QuentinCaldeira/Arduino_Shield/Docs/Images/img.png

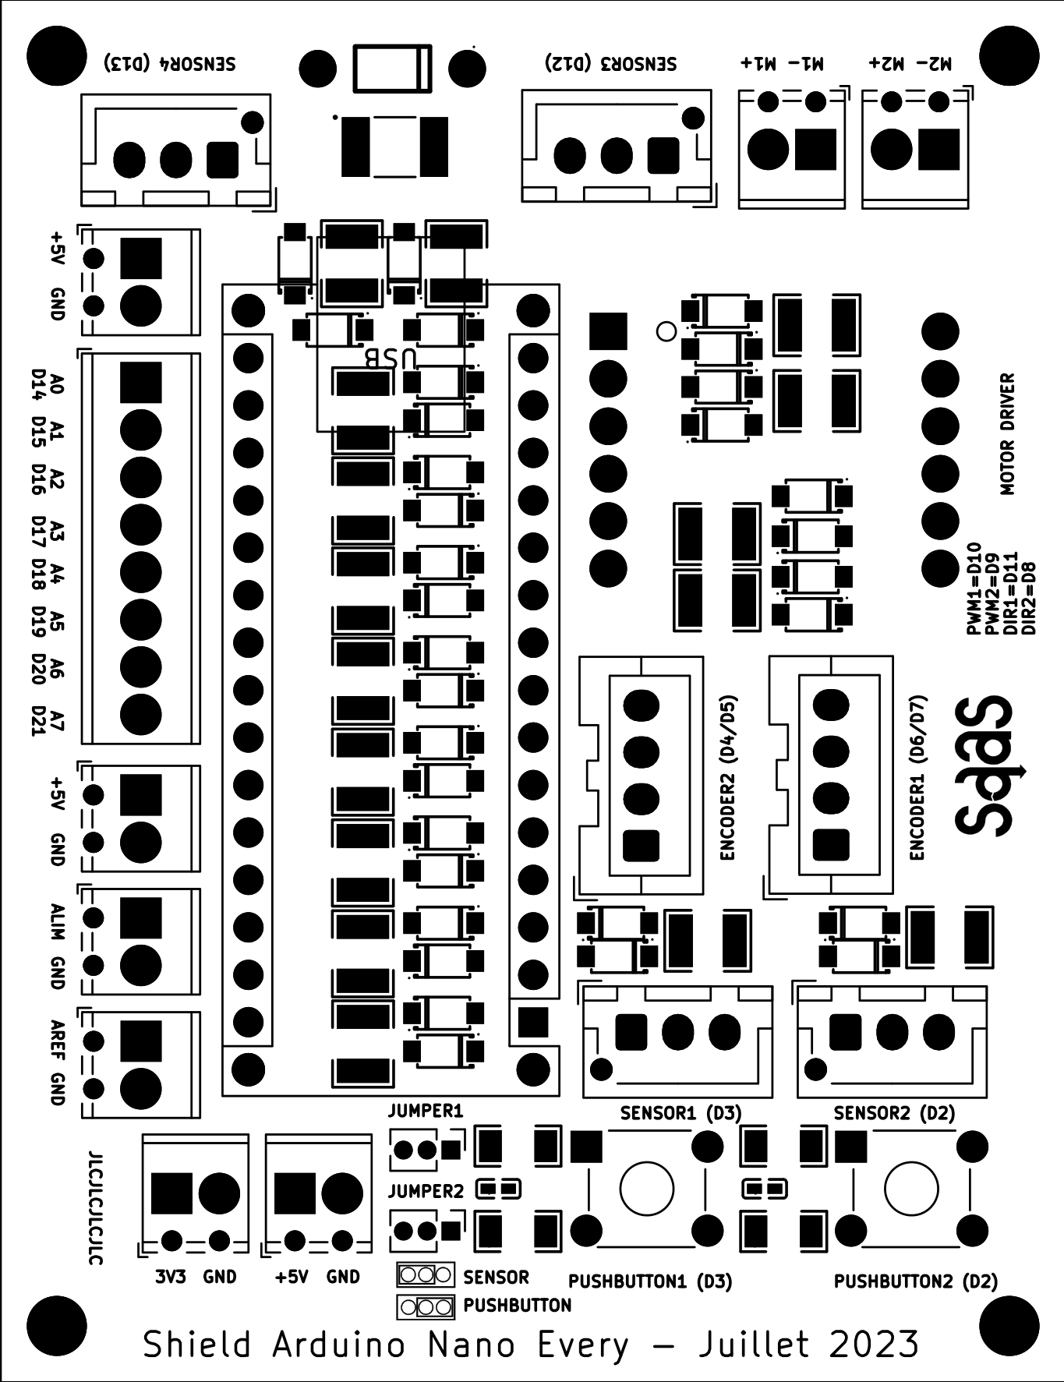
Docs/Images/img.png
