QuentinCaldeira/Arduino_Shield/SHIELD V2 PCB/BOM - Copie.xlsx

Comment | Designator | Footprint | JLCPCB Part #（optional）
330 | R1, R2, R3, R4, R5, R6, R7, R8, R9, R10, R11, R12, R13, R14, R15, R16 |  | C2933855
10k | R18, R20 |  | C3013377
Diode Schottky | D1, D2, D3, D4, D5, D6, D7, D8, D9, D10, D11, D12, D13, D14, D15, D16, D17, D18, D19, D20, D21, D22, D23, D24, D25, D26, D27, D28, D29, D30, D32, D33 |  | C8572
Diode | D31 |  | C2456
SMD | F1 |  | C108518
15nF | C1, C2 |  | C363529
110k | R17, R19 |  | C102274
 | J13, J3, J2, J1 |  | C161870
 | J10, J7 |  | C264994
 | J9, J11, J17, J6, J12, J19, J18, J4 |  | C2840316
