QuentinCaldeira/Arduino_Shield/Docs/Images/img.pdf

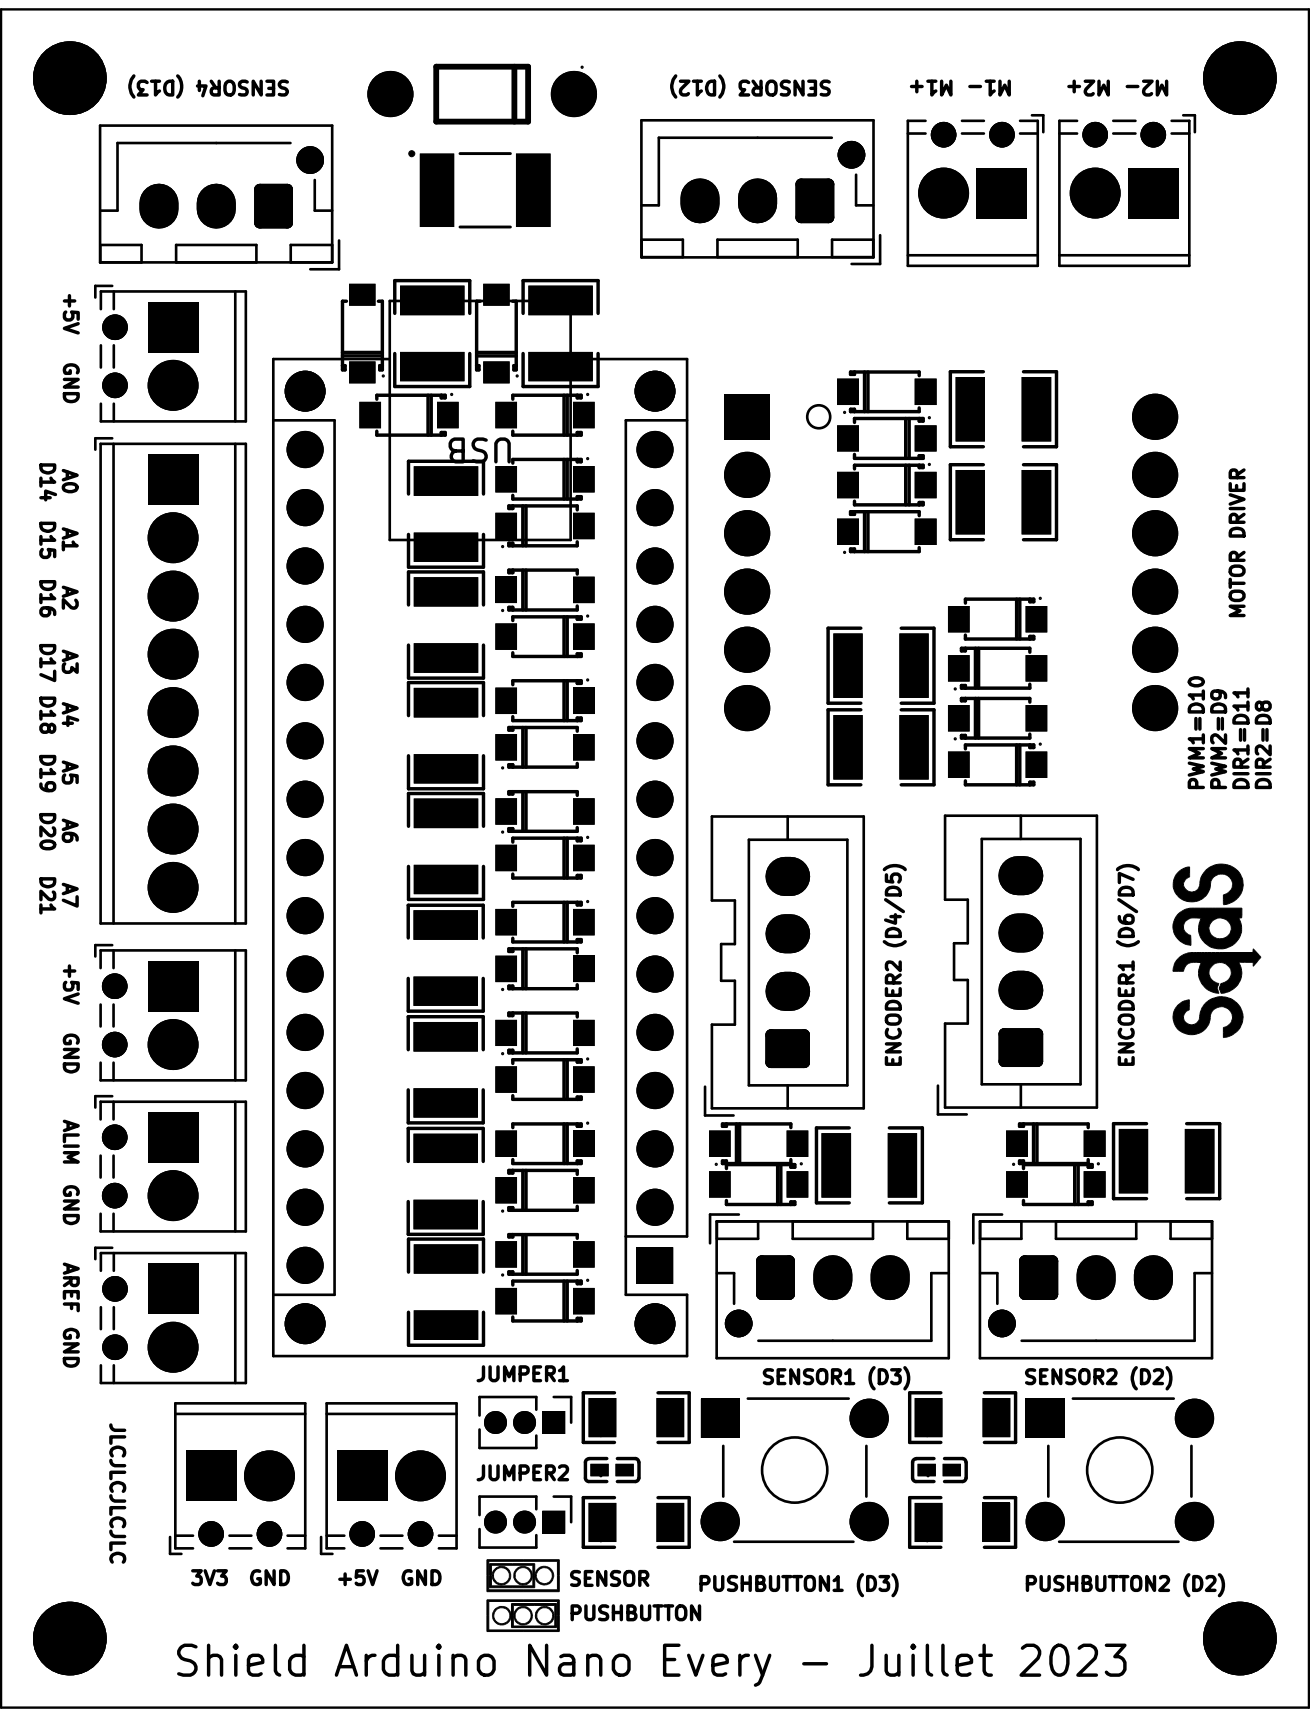
[picture p10: page 1]
