QuentinCaldeira/Arduino_Shield/SHIELD V1 PCB/bottom.pdf

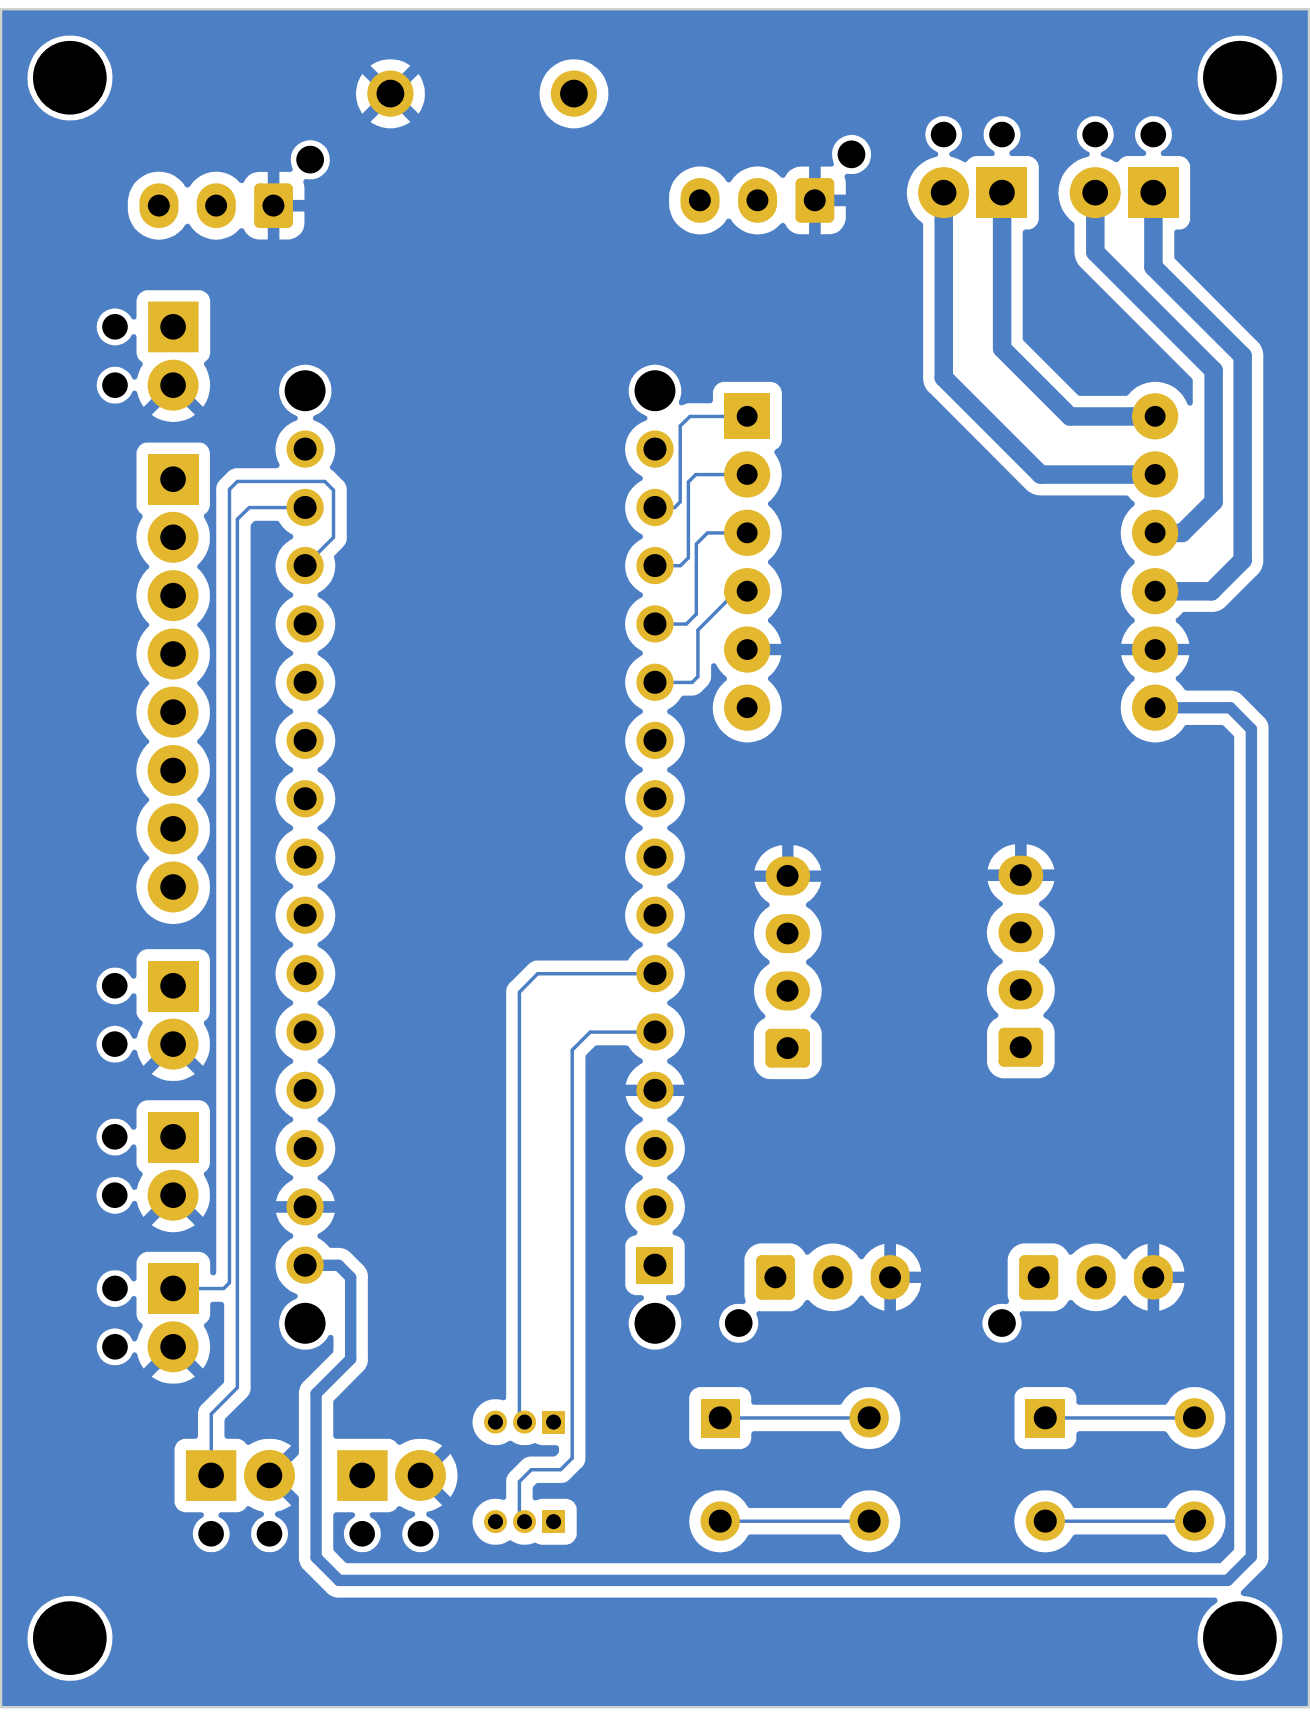
[picture p11: page 1]
