QuentinCaldeira/Arduino_Shield/SHIELD V1 PCB/cote.pdf

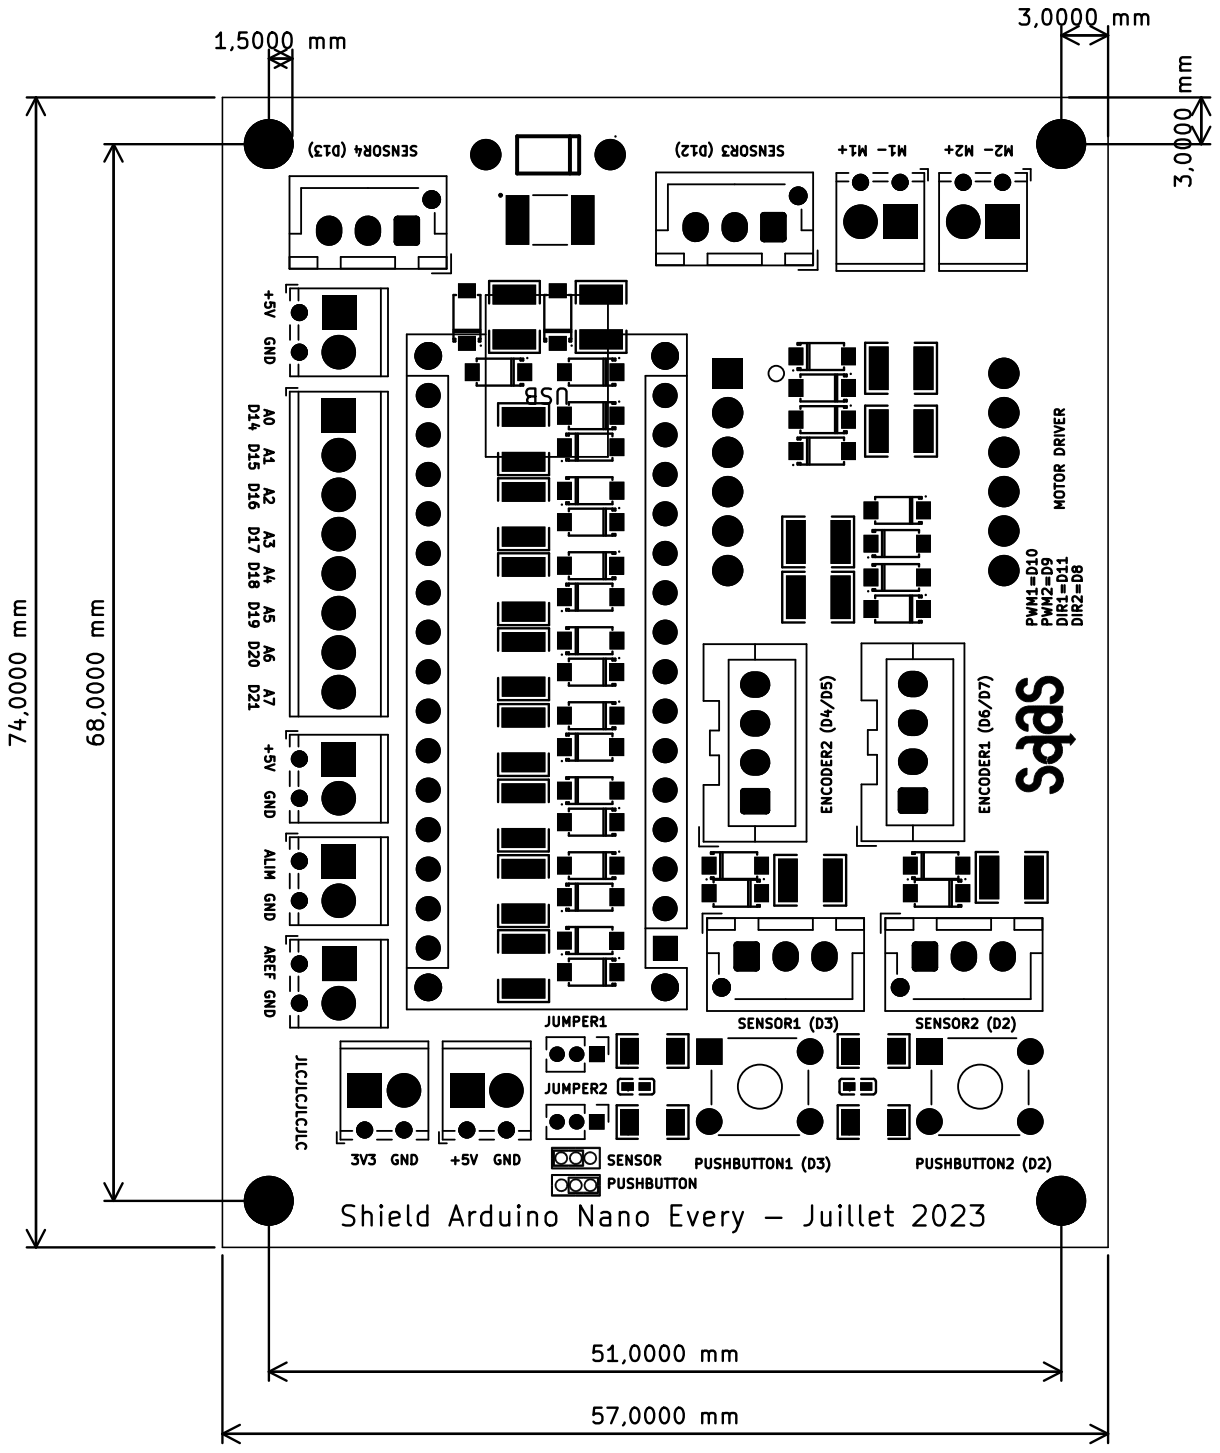
[picture p12: page 1]
