QuentinCaldeira/Arduino_Shield/SHIELD V1 PCB/sch.pdf

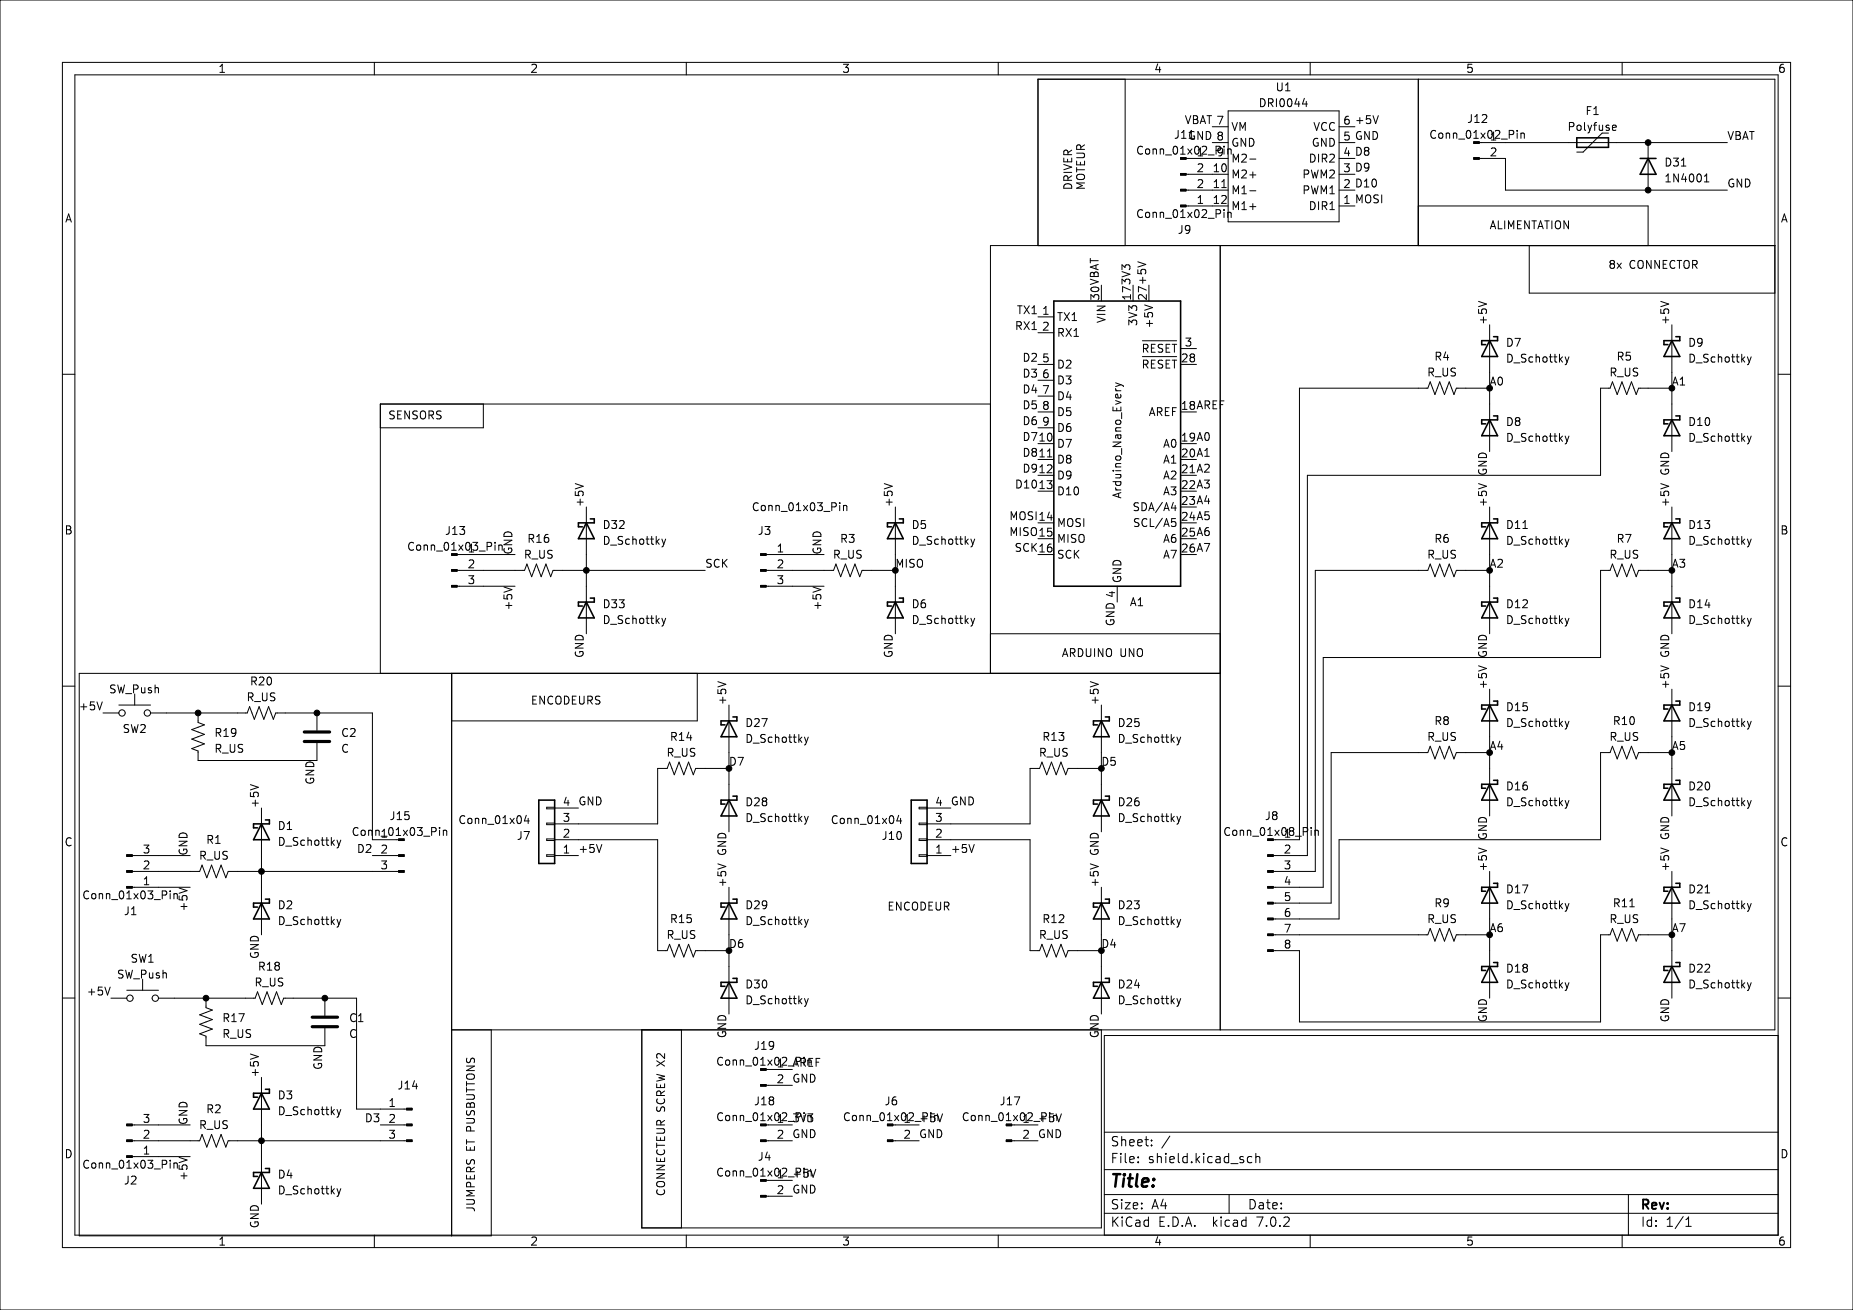
[picture p13: page 1]
