QuentinCaldeira/Arduino_Shield/SHIELD V1 PCB/top.pdf

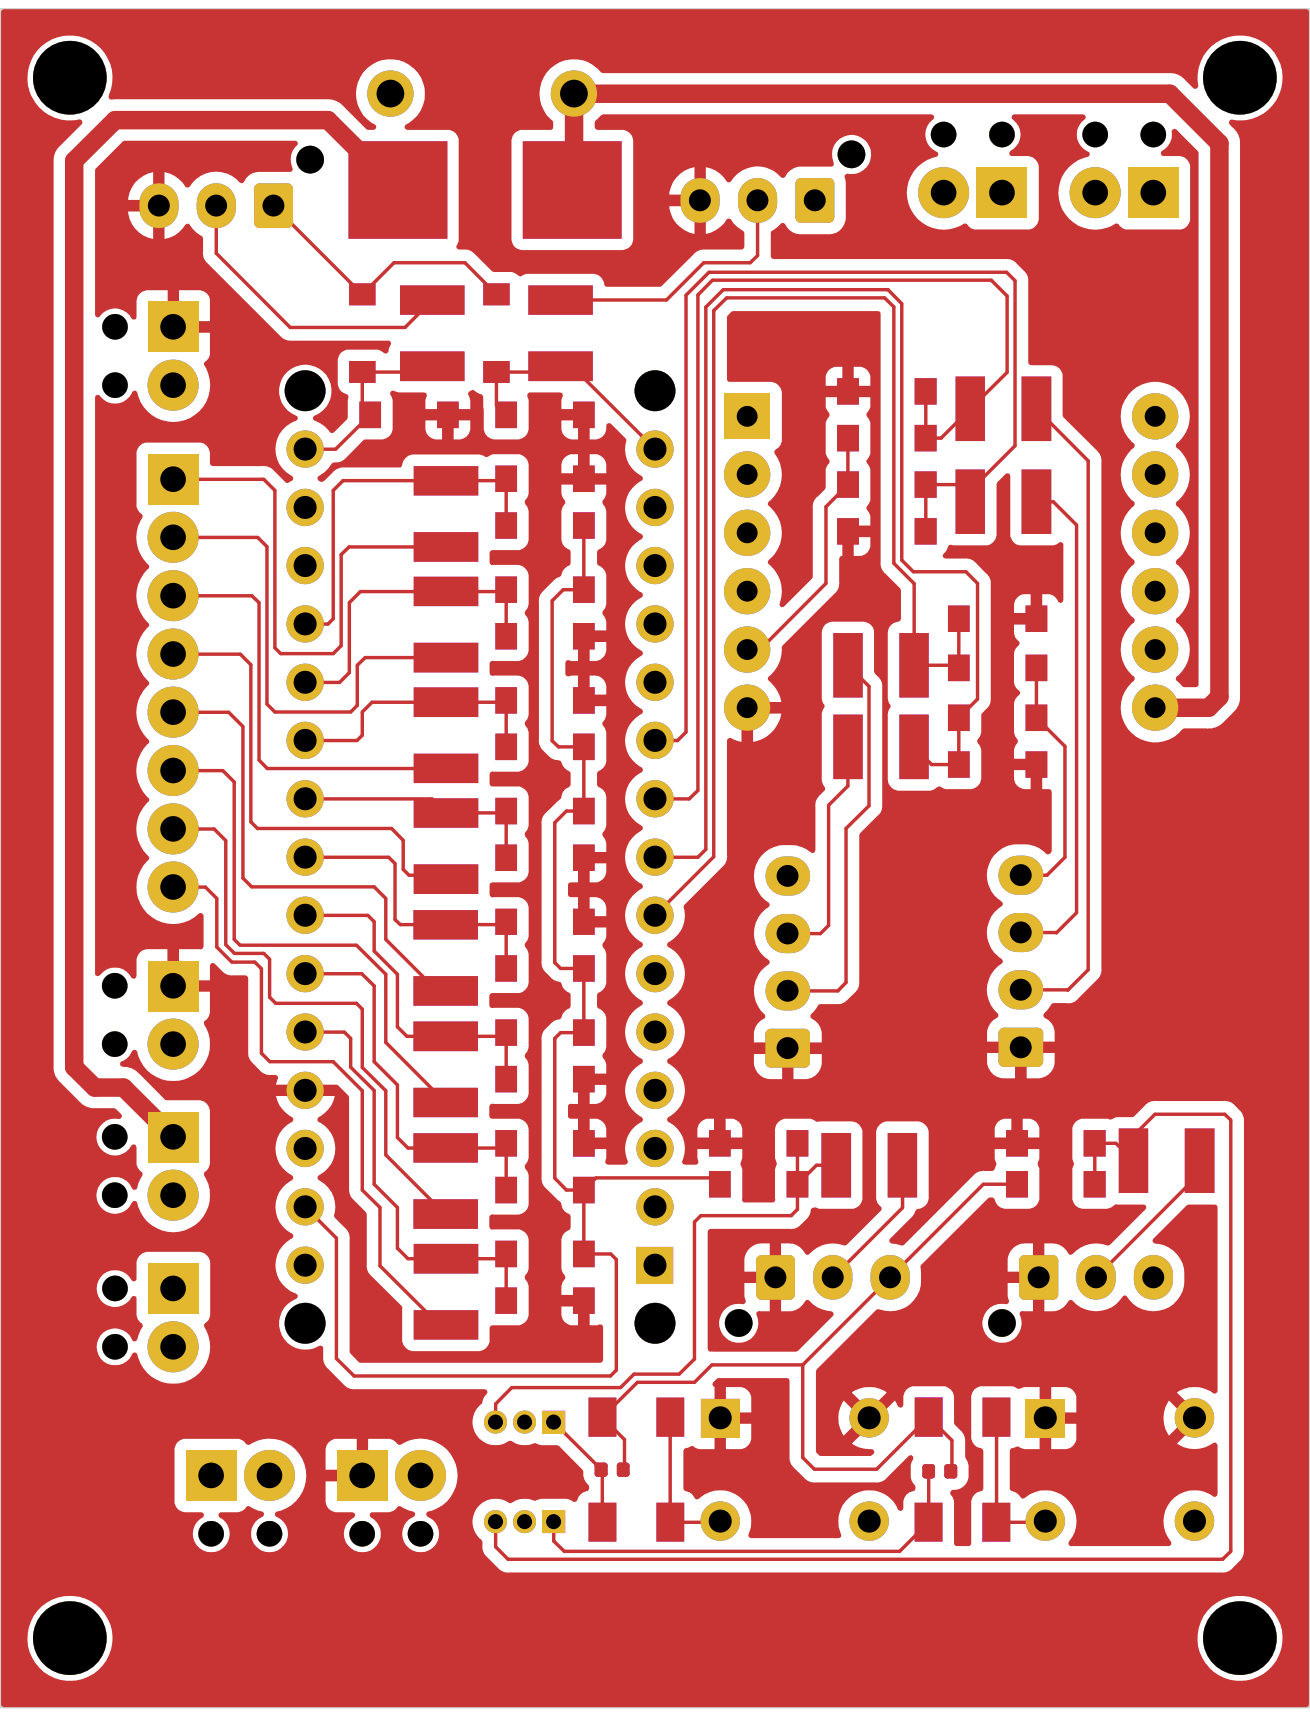
[picture p14: page 1]
