QuentinCaldeira/Arduino_Shield/SHIELD V2 PCB/shield/shield.kicad_pcb

## KiCad design SHIELD V2 PCB/shield/shield.kicad_pcb (2023-08-03)

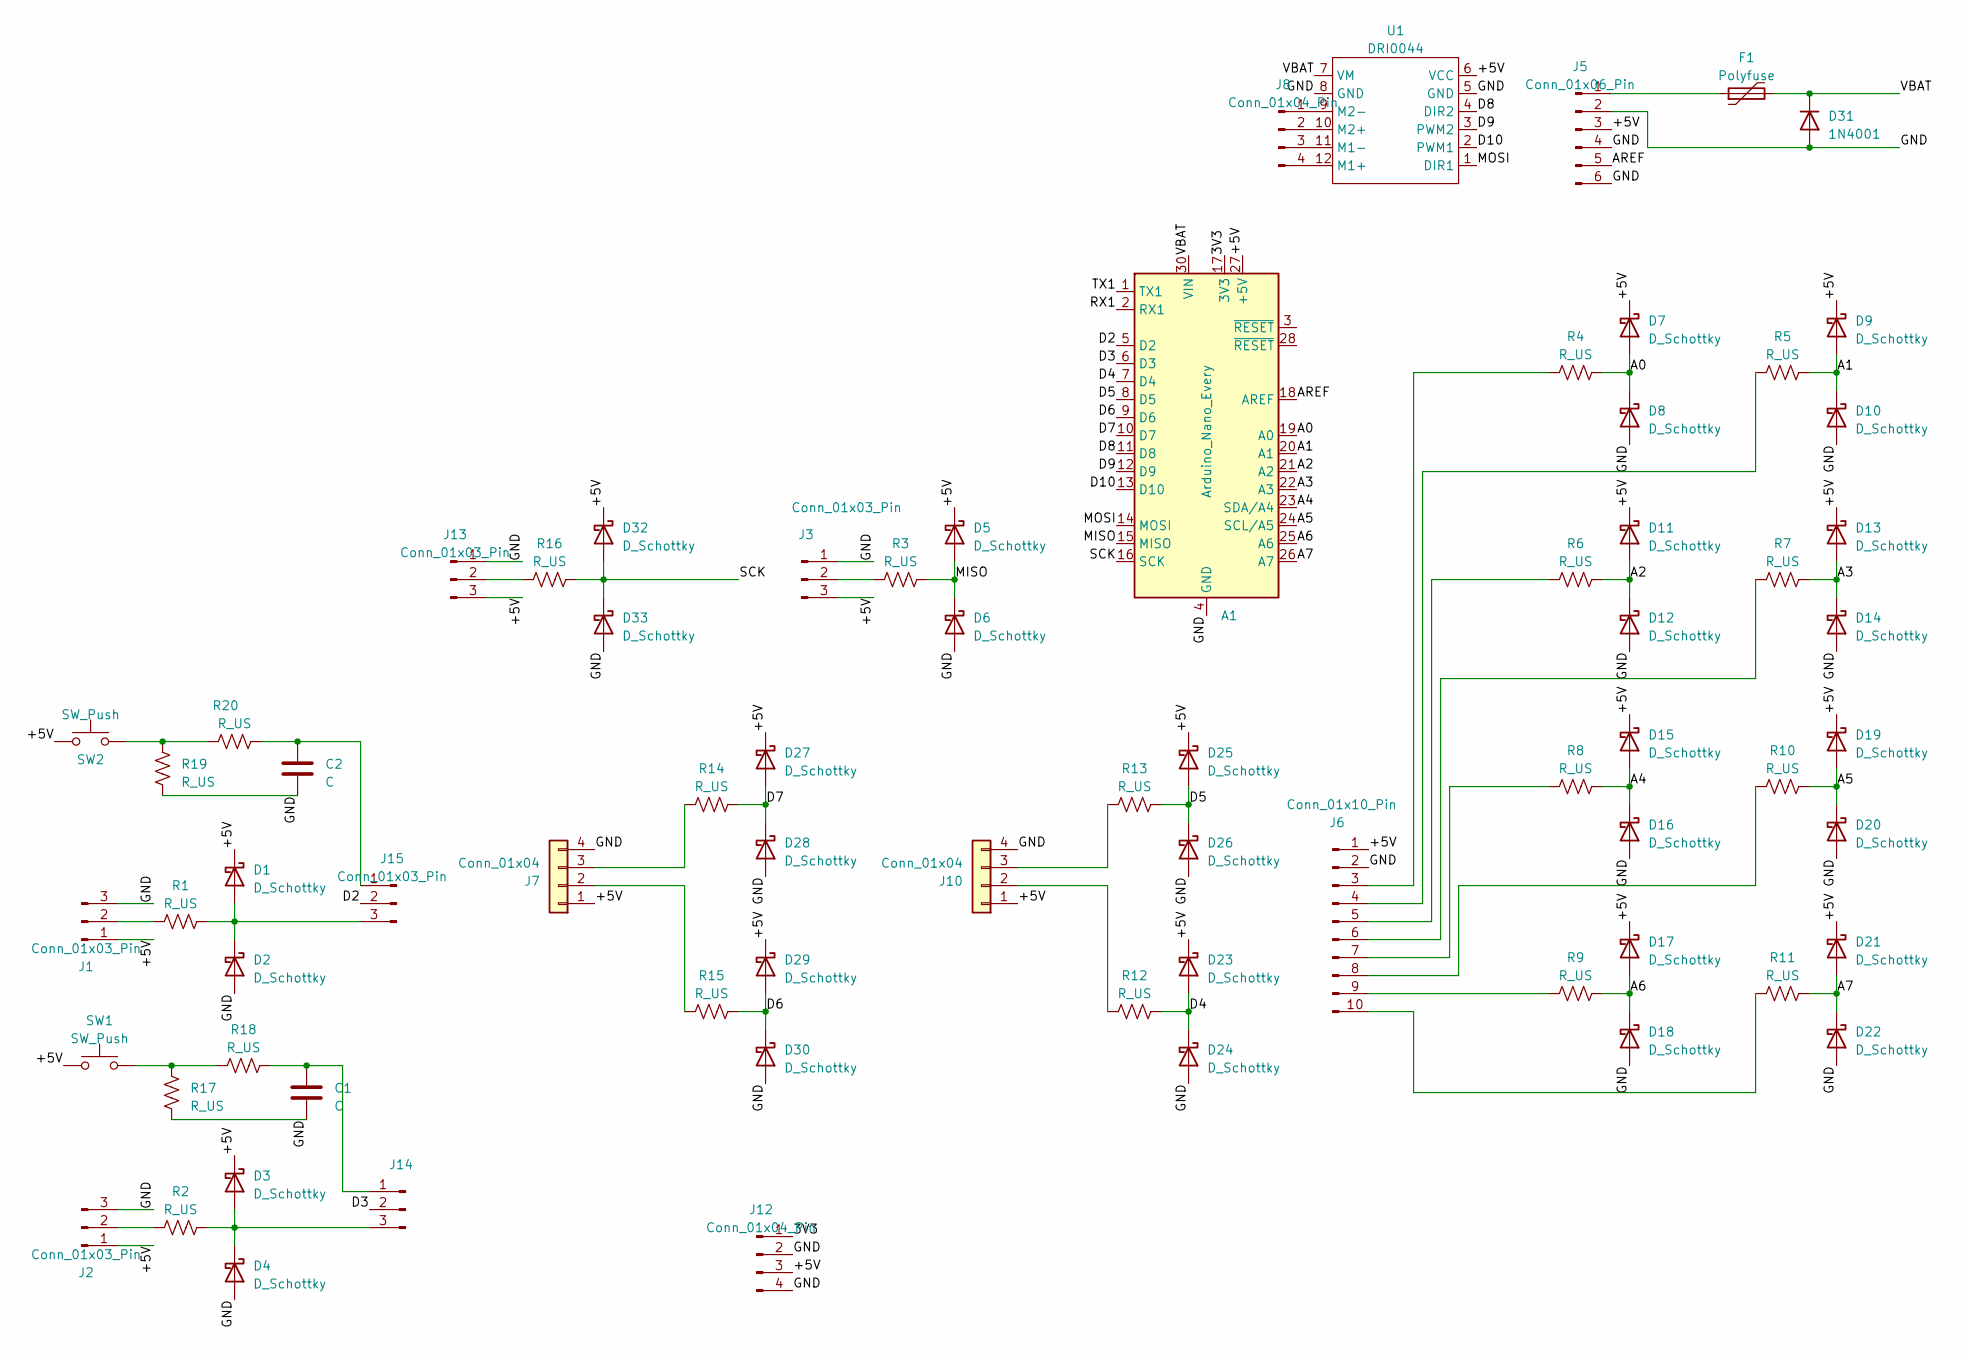
[picture p15: schematic shield.kicad_sch]

Parts:
A1: Arduino_Nano_Every; Arduino_Nano_WithMountingHoles
C1, C2: C; capa_10nF
D1, D2, D3, D4, D5, D6, D7, D8, D9, D10, D11, D12, D13, D14, D15, D16, D17, D18, D19, D20, D21, D22, D23, D24, D25, D26, D27, D28, D29, D30, D32, D33: D_Schottky; SOD-123_L2.8-W1.8-LS3.7-RD
D31: 1N4001; D_DO-41_SOD81_P10.16mm_Horizontal
F1: Polyfuse; FUSM4632X85
J1, J2, J3, J13: Conn_01x03_Pin; JST_XH_B3B-XH-AM_1x03_P2.50mm_Vertical
J5: Conn_01x06_Pin; TerminalBlock_Phoenix_MPT-0,5-6-2.54_1x06_P2.54mm_Horizontal
J6: Conn_01x10_Pin; TerminalBlock_Phoenix_MPT-0,5-10-2.54_1x10_P2.54mm_Horizont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
J7, J10: Conn_01x04; JST_XA_B04B-XASK-1_1x04_P2.50mm_Vertical
J8, J12: Conn_01x04_Pin; TerminalBlock_Phoenix_MPT-0,5-4-2.54_1x04_P2.54mm_Horizontal
J14, J15: Conn_01x03_Pin; PinHeader_1x03_P2.54mm_Vertical
R1, R2, R3, R4, R5, R6, R7, R8, R9, R10, R11, R12, R13, R14, R15, R16: R_US; R1210
R17, R18, R19, R20: R_US; R1206
SW1, SW2: SW_Push; SW_TH_Tactile_Omron_B3F-10xx
U1: DRI0044

Connections:
/3V3: A1.17 (3V3), J12.1
/+5V: A1.27 (+5V), D1.1 (K), D3.1 (K), D5.1 (K), D7.1 (K), D9.1 (K), D11.1 (K), D13.1 (K), D15.1 (K), D17.1 (K), D19.1 (K), D21.1 (K), D23.1 (K), D25.1 (K), D27.1 (K), D29.1 (K), D32.1 (K), J1.1, J2.1, J3.3, J5.3, J6.1, J7.1, J10.1, J12.3, J13.3, SW1.1, SW2.1, U1.6 (VCC)
/A0: A1.19 (A0), D7.2 (A), D8.1 (K), R4.2
/A1: A1.20 (A1), D9.2 (A), D10.1 (K), R5.2
/A2: A1.21 (A2), D11.2 (A), D12.1 (K), R6.2
/A3: A1.22 (A3), D13.2 (A), D14.1 (K), R7.2
/A4: A1.23 (SDA/A4), D15.2 (A), D16.1 (K), R8.2
/A5: A1.24 (SCL/A5), D19.2 (A), D20.1 (K), R10.2
/A6: A1.25 (A6), D17.2 (A), D18.1 (K), R9.2
/A7: A1.26 (A7), D21.2 (A), D22.1 (K), R11.2
/AREF: A1.18 (AREF), J5.5
/D2: A1.5 (D2), J15.2
/D3: A1.6 (D3), J14.2
/D4: A1.7 (D4), D23.2 (A), D24.1 (K), R12.2
/D5: A1.8 (D5), D25.2 (A), D26.1 (K), R13.2
/D6: A1.9 (D6), D29.2 (A), D30.1 (K), R15.2
/D7: A1.10 (D7), D27.2 (A), D28.1 (K), R14.2
/D8: A1.11 (D8), U1.4 (DIR2)
/D9: A1.12 (D9), U1.3 (PWM2)
/D10: A1.13 (D10), U1.2 (PWM1)
/GND: A1.4 (GND), A1.29 (GND), C1.2, C2.2, D2.2 (A), D4.2 (A), D6.2 (A), D8.2 (A), D10.2 (A), D12.2 (A), D14.2 (A), D16.2 (A), D18.2 (A), D20.2 (A), D22.2 (A), D24.2 (A), D26.2 (A), D28.2 (A), D30.2 (A), D31.2 (A), D33.2 (A), J1.3, J2.3, J3.1, J5.2, J5.4, J5.6, J6.2, J7.4, J10.4, J12.2, J12.4, J13.1, R17.1, R19.1, U1.5 (GND), U1.8 (GND)
/MISO: A1.15 (MISO), D5.2 (A), D6.1 (K), R3.2
/MOSI: A1.14 (MOSI), U1.1 (DIR1)
/RX1: A1.2 (RX1)
/SCK: A1.16 (SCK), D32.2 (A), D33.1 (K), R16.2
/TX1: A1.1 (TX1)
/VBAT: A1.30 (VIN), D31.1 (K), F1.2, U1.7 (VM)
unnamed: D1.2 (A), D2.1 (K), J15.3, R1.2
unnamed: D3.2 (A), D4.1 (K), J14.3, R2.2
unnamed: J1.2, R1.1
unnamed: J2.2, R2.1
unnamed: J3.2, R3.1
unnamed: F1.1, J5.1
unnamed: J6.3, R4.1
unnamed: J6.4, R5.1
unnamed: J6.5, R6.1
unnamed: J6.6, R7.1
unnamed: J6.7, R8.1
unnamed: J6.8, R10.1
unnamed: J6.9, R9.1
unnamed: J6.10, R11.1
unnamed: J7.2, R15.1
unnamed: J7.3, R14.1
unnamed: J8.1, U1.9 (M2-)
unnamed: J8.2, U1.10 (M2+)
unnamed: J8.3, U1.11 (M1-)
unnamed: J8.4, U1.12 (M1+)
unnamed: J10.2, R12.1
unnamed: J10.3, R13.1
unnamed: J13.2, R16.1
unnamed: C1.1, J14.1, R18.1
unnamed: C2.1, J15.1, R20.1
unnamed: R17.2, R18.2, SW1.2
unnamed: R19.2, R20.2, SW2.2

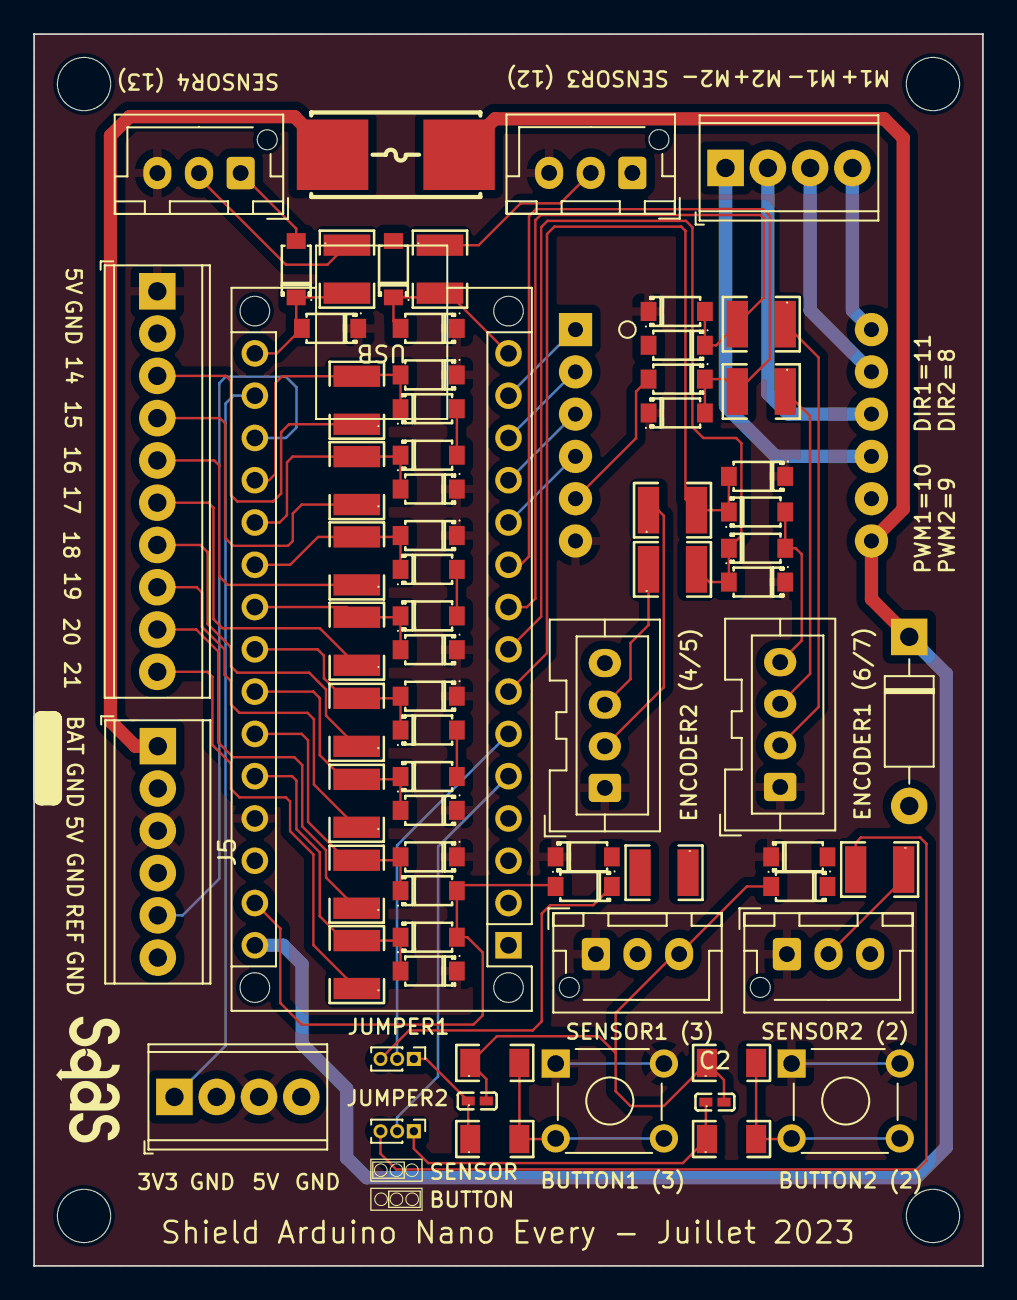
[picture p16: board shield.kicad_pcb from above]

Board: 2 copper layers, 57.0 x 74.0 mm, 72 parts (0 on the bottom side), 52 nets.
