QuentinCaldeira/Arduino_Shield/(commit log)

2023-07-20 Update repo with doc and pcb
    [BOM.xlsx, shield.kicad_pcb, shield.kicad_sch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]
2023-08-03 Add a V2 board
    Bigger text and less screw terminals
    [BOM - Copie.xlsx, BOM.xlsx, shield.kicad_pcb, shield.kicad_sch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]
